oubay-gabsi/ESP32-Self-Balancing-Robot/CAD/solidworks/robot.SLDPRT

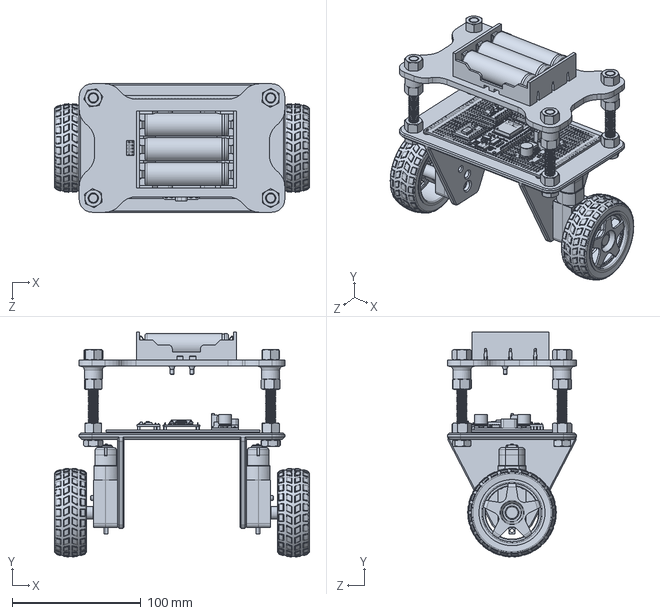
[picture p6: CAD file, 2026-11-08]
CAD/solidworks/robot.SLDPRT
198.4 x 174.8 x 100.0 mm
