oubay-gabsi/ESP32-Self-Balancing-Robot/CAD/solidworks/frame.SLDPRT

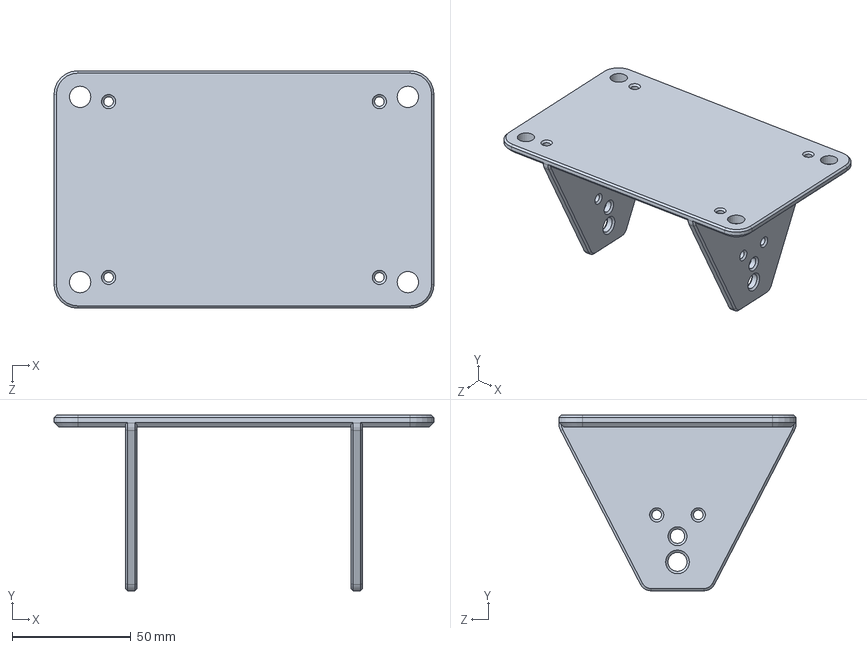
[picture p7: CAD file, 2026-11-08]
CAD/solidworks/frame.SLDPRT
160.0 x 74.0 x 100.0 mm
