oubay-gabsi/ESP32-Self-Balancing-Robot/CAD/solidworks/battery_holder.SLDPRT

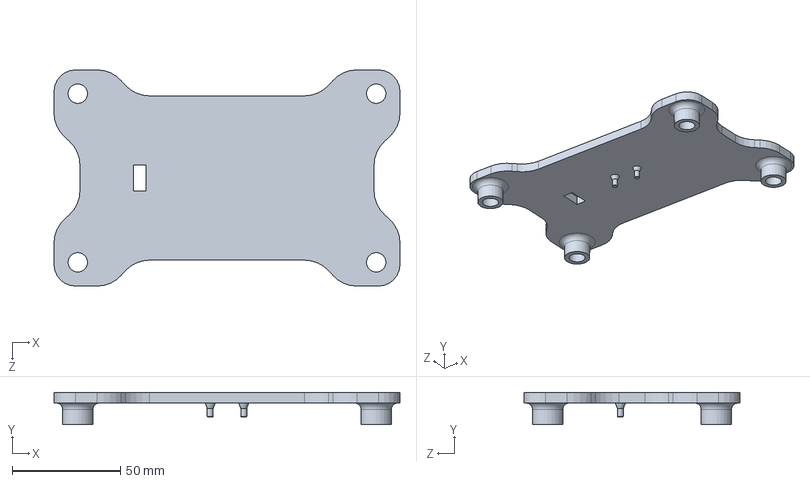
[picture p8: CAD file, 2026-11-08]
CAD/solidworks/battery_holder.SLDPRT
160.0 x 15.0 x 100.0 mm
