oubay-gabsi/ESP32-Self-Balancing-Robot/(list of files, cad)

Other CAD files:
CAD/step/robot_assembly.STEP
CAD/stl/battery_holder.STL
CAD/stl/frame.STL
