oubay-gabsi/ESP32-Self-Balancing-Robot/(list of files, drawings)

Other design files:
Hardware/Circuit shema.fzz
